tettou771/CadenceSensor/3d/case.3mf

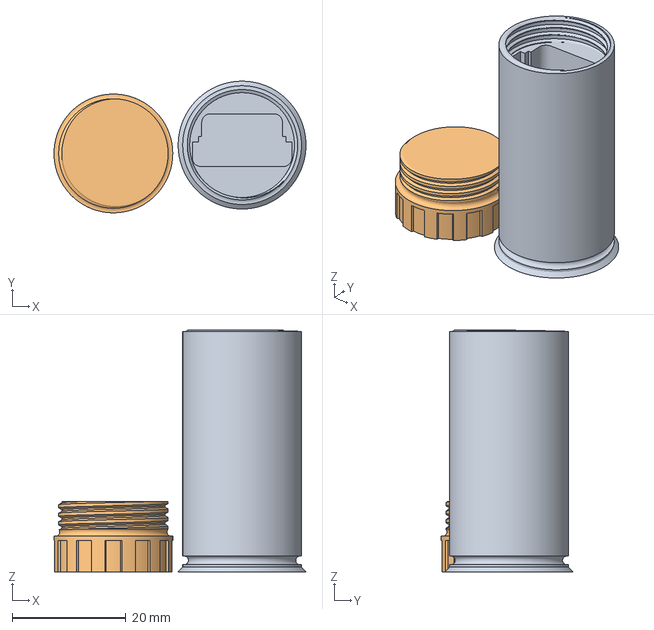
[picture p1: CAD file, 2026-08-18]
3d/case.3mf
44.3 x 23.2 x 42.5 mm
outer.stl
cap.stl
