tettou771/CadenceSensor/KiCad/BikeSensor/BikeSensor.step

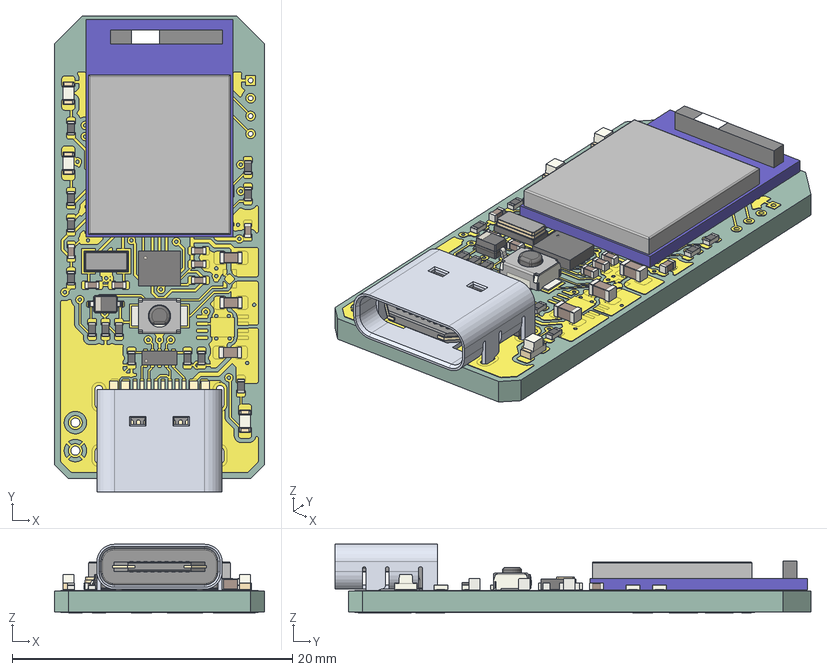
[picture p2: CAD file, 2026-08-17]
KiCad/BikeSensor/BikeSensor.step
15.0 x 34.0 x 4.89 mm
R_0402_1005Metric x 13
LED_0603_1608Metric x 3
C_0402_1005Metric x 7
SW_SPST_B3U-1000P
C_0603_1608Metric x 3
LGA_14_3x25mm_P05mm_LayoutBorder3x4y
D_SOD-323
Crystal_SMD_3215-2Pin_3.2x1.5mm
Raytac_MDBT50Q
USON_10_25x10mm_Pitch05mm
USB Type C Port (SMD Type)
BikeSensor_copper
BikeSensor_PCB
