tettou771/CadenceSensor/KiCad/BikeSensor/BikeSensor.kicad_pcb

## KiCad design KiCad/BikeSensor/BikeSensor.kicad_pcb (2026-08-18)

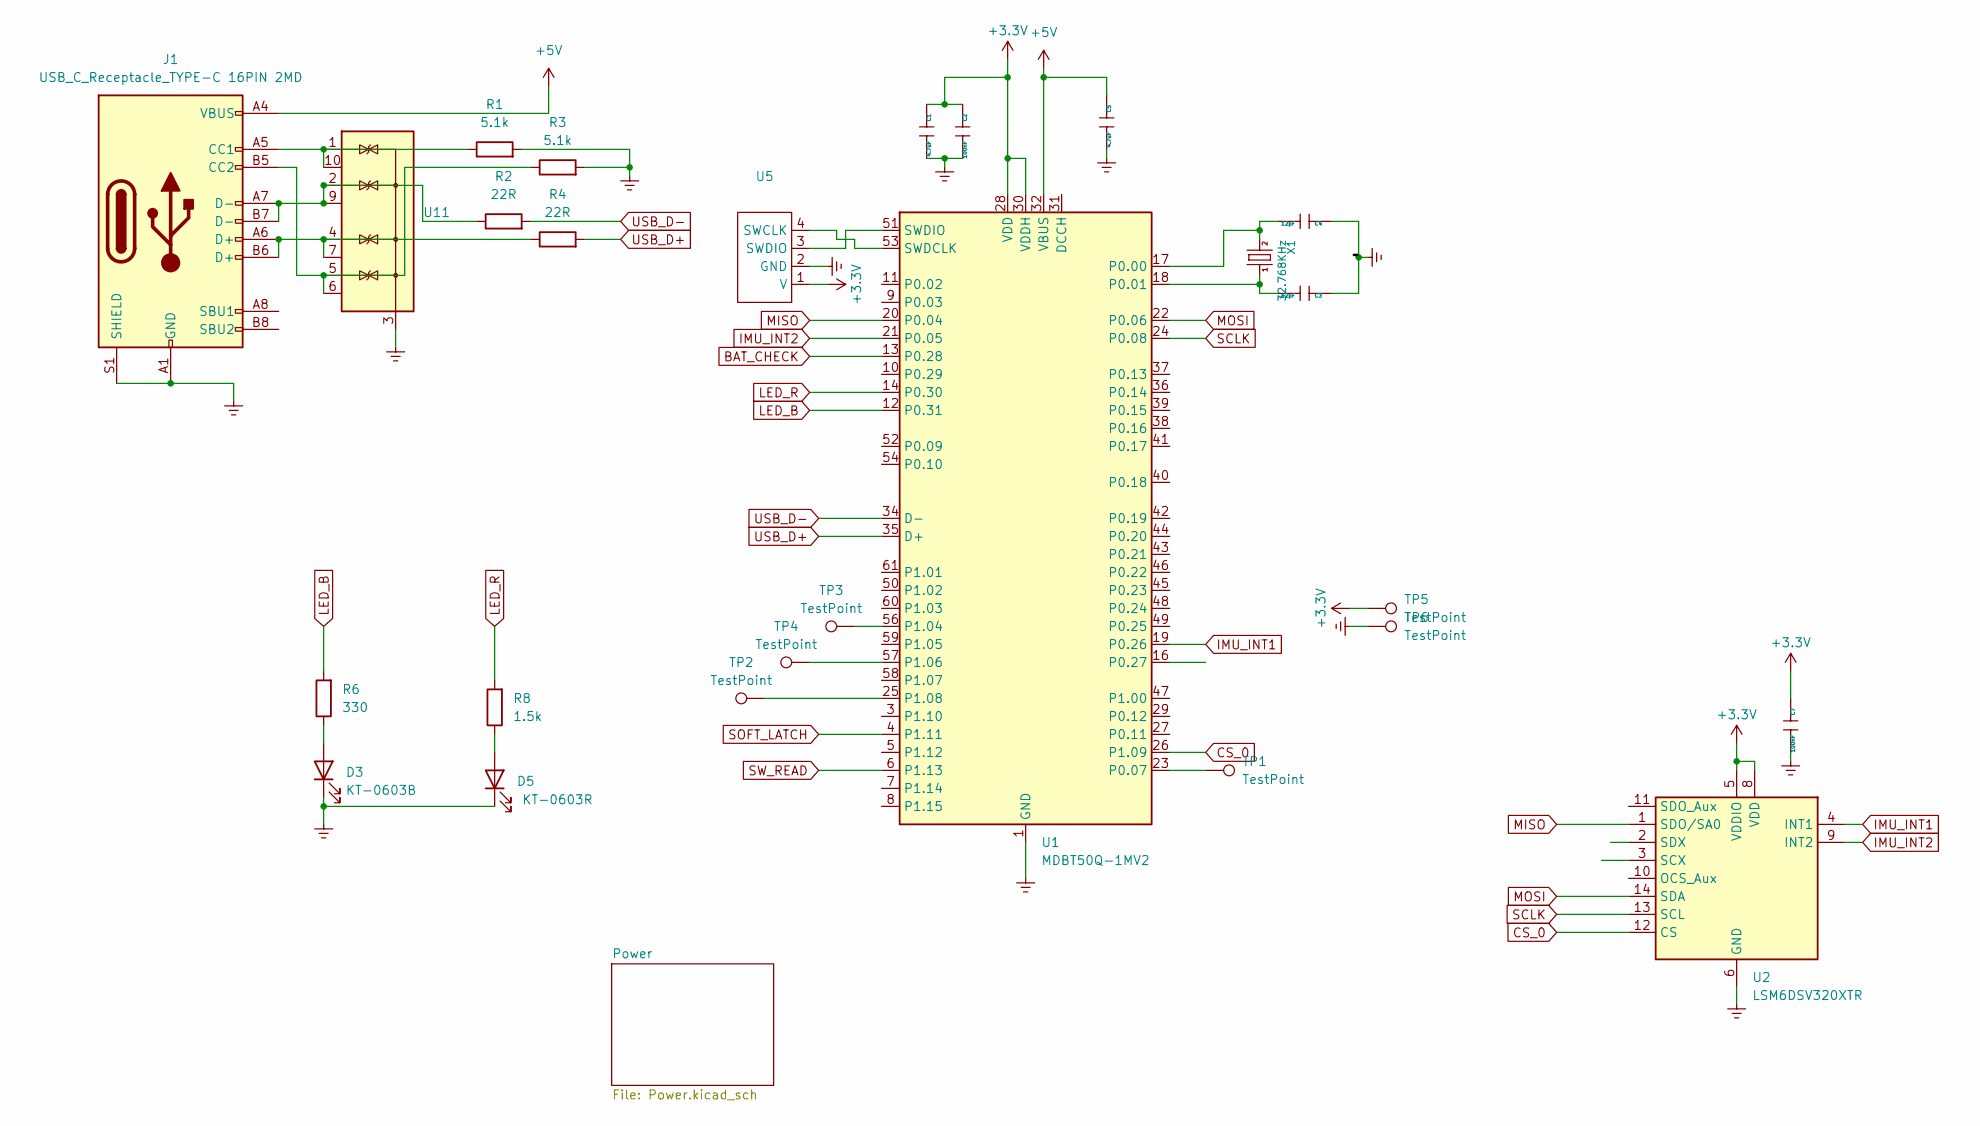
[picture p3: schematic BikeSensor.kicad_sch]

Parts:
C1, C5: 4.7uF; C_0402_1005Metric
C2, C7: 100nF; C_0402_1005Metric
C3, C4: 12pF; C_0402_1005Metric
D3: KT-0603B; LED_0603_1608Metric
D5: KT-0603R; LED_0603_1608Metric
J1: USB_C_Receptacle_TYPE-C 16PIN 2MD
R1, R3: 5.1k; R_0402_1005Metric
R2, R4: 22R; R_0402_1005Metric
R6: 330; R_0402_1005Metric
R8: 1.5k; R_0402_1005Metric
TP1, TP2, TP3, TP4, TP5, TP6: TestPoint; TestPoint_Pad_D1.5mm
U1: MDBT50Q-1MV2; Raytac_MDBT50Q
U2: LSM6DSV320XTR; LGA-14_3x2.5mm_P0.5mm_LayoutBorder3x4y
U5: ICSP_SWD_127
U11: TPD4E02B04DQA; USON-10_2.5x1.0mm_P0.5mm
X1: 32.768KHz; Crystal_SMD_3215-2Pin_3.2x1.5mm

Connections:
+3.3V: C1.1, C2.1, C7.1, TP5.1 (1_1), U1.28 (VDD), U1.30 (VDDH), U2.5 (VDDIO), U2.8 (VDD), U5.1 (V); also elsewhere on the board
+5V: C5.1, J1.A4 (VBUS), J1.A9 (VBUS), J1.B4 (VBUS), J1.B9 (VBUS), U1.32 (VBUS); also elsewhere on the board
BAT_CHECK: U1.13 (P0.28); also elsewhere on the board
CS_0: U1.26 (P1.09), U2.12 (CS)
GND_POWER: C1.2, C2.2, C3.1, C4.1, C5.2, C7.2, D3.1 (K), D5.1 (K), J1.A1 (GND), J1.A12 (GND), J1.B1 (GND), J1.B12 (GND), J1.S1 (SHIELD), R1.2, R3.2, TP6.1 (1_1), U1.1 (GND), U1.2 (GND), U1.15 (GND), U1.33 (GND), U1.55 (GND), U2.6 (GND), U2.7 (GND), U5.2 (GND), U11.3 (G), U11.8 (G); also elsewhere on the board
IMU_INT1: U1.19 (P0.26), U2.4 (INT1)
IMU_INT2: U1.21 (P0.05), U2.9 (INT2)
LED_B: R6.2, U1.12 (P0.31)
LED_R: R8.2, U1.14 (P0.30)
MISO: U1.20 (P0.04), U2.1 (SDO/SA0)
MOSI: U1.22 (P0.06), U2.14 (SDA)
unnamed: D3.2 (A), R6.1
unnamed: D5.2 (A), R8.1
unnamed: J1.A5 (CC1), R1.1, U11.1 (IO1), U11.10 (NC)
unnamed: J1.B5 (CC2), R3.1, U11.5 (IO4), U11.6 (NC)
unnamed: C4.2, U1.17 (P0.00), X1.2
unnamed: C3.2, U1.18 (P0.01), X1.1
unnamed: TP1.1 (1_1), U1.23 (P0.07)
unnamed: TP3.1 (1_1), U1.56 (P1.04)
unnamed: TP4.1 (1_1), U1.57 (P1.06)
unnamed: TP2.1 (1_1), U1.25 (P1.08)
unnamed: U1.53 (SWDCLK), U5.4 (SWCLK)
unnamed: U1.51 (SWDIO), U5.3 (SWDIO)
unnamed: J1.A7 (D-), J1.B7 (D-), R2.1, U11.2 (IO2), U11.9 (NC)
unnamed: J1.A6 (D+), J1.B6 (D+), R4.1, U11.4 (IO3), U11.7 (NC)
SCLK: U1.24 (P0.08), U2.13 (SCL)
SOFT_LATCH: U1.4 (P1.11); also elsewhere on the board
SW_READ: U1.6 (P1.13); also elsewhere on the board
USB_D+: R4.2, U1.35 (D+)
USB_D-: R2.2, U1.34 (D-)

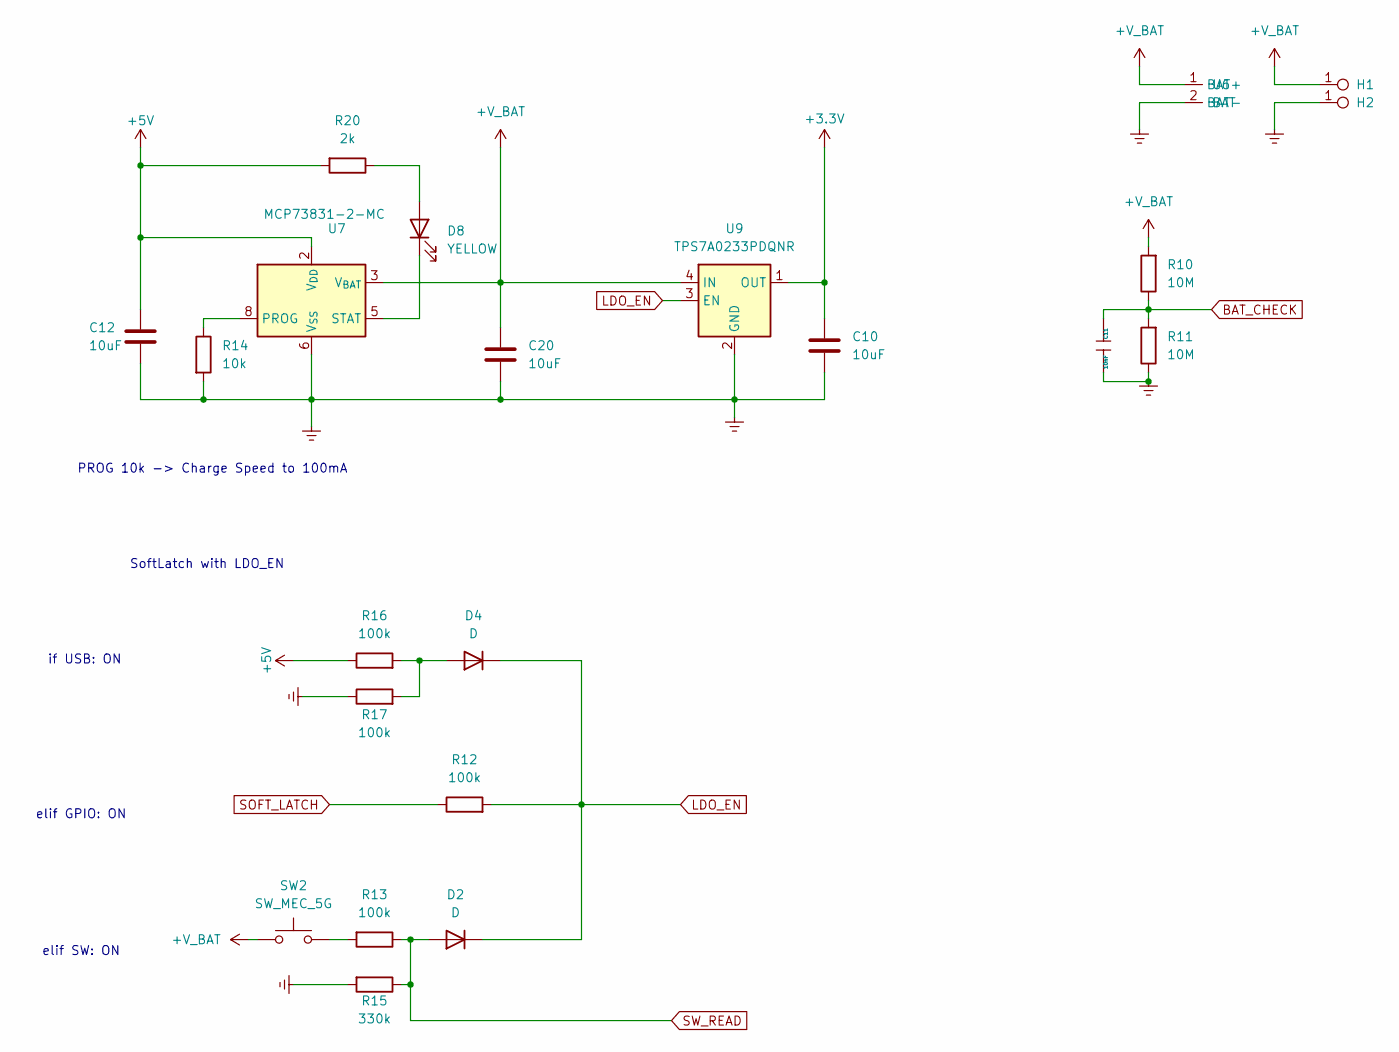
[picture p4: schematic Power.kicad_sch]

Parts:
C10, C12, C20: 10uF; C_0603_1608Metric
C11: 10nF; C_0402_1005Metric
D2, D4: D; D_SOD-323
D8: YELLOW; LED_0603_1608Metric
H1, H2: TH_0.7mm
R10, R11: 10M; R_0402_1005Metric
R12, R13, R16, R17: 100k; R_0402_1005Metric
R14: 10k; R_0402_1005Metric
R15: 330k; R_0402_1005Metric
R20: 2k; R_0402_1005Metric
SW2: SW_MEC_5G; SW_SPST_B3U-1000P
U6: BAT; SPK_PAD
U7: MCP73831-2-MC; DFN-8-1EP_3x2mm_P0.5mm_EP1.7x1.4mm
U9: TPS7A0233PDQNR; Texas_X2SON-4_1x1mm_P0.65mm

Connections:
+3.3V: C10.1, U9.1 (OUT); also elsewhere on the board
+5V: C12.1, R16.1, R20.2, U7.1 (V_{DD}), U7.2 (V_{DD}); also elsewhere on the board
+V_BAT: C20.1, H1.1, R10.2, SW2.1 (A), U6.1 (BAT+), U7.3 (V_{BAT}), U7.4 (V_{BAT}), U9.4 (IN)
BAT_CHECK: C11.1, R10.1, R11.2; also elsewhere on the board
GND_POWER: C10.2, C11.2, C12.2, C20.2, H2.1, R11.1, R14.2, R15.2, R17.1, U6.2 (BAT-), U7.6 (V_{SS}), U9.2 (GND), U9.5 (GND); also elsewhere on the board
LDO_EN: D2.1 (K), D4.1 (K), R12.2, U9.3 (EN)
unnamed: D4.2 (A), R16.2, R17.2
unnamed: D8.2 (A), R20.1
unnamed: D8.1 (K), U7.5 (STAT)
unnamed: R13.2, SW2.2 (B), SW2.3 (B)
unnamed: R14.1, U7.8 (PROG)
SOFT_LATCH: R12.1; also elsewhere on the board
SW_READ: D2.2 (A), R13.1, R15.1; also elsewhere on the board

Notes on the sheet:
elif SW: ON
PROG 10k -> Charge Speed to 100mA
elif GPIO: ON
if USB: ON
SoftLatch with LDO_EN

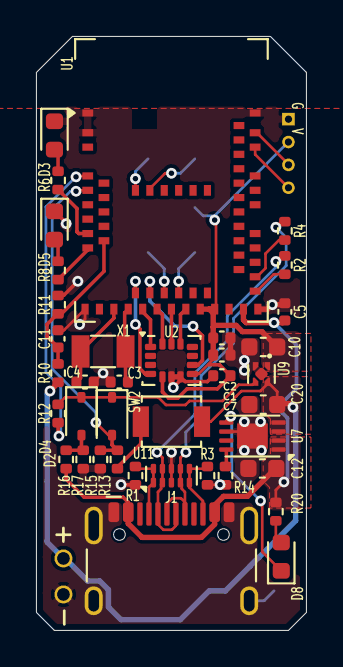
[picture p5: board BikeSensor.kicad_pcb from above]

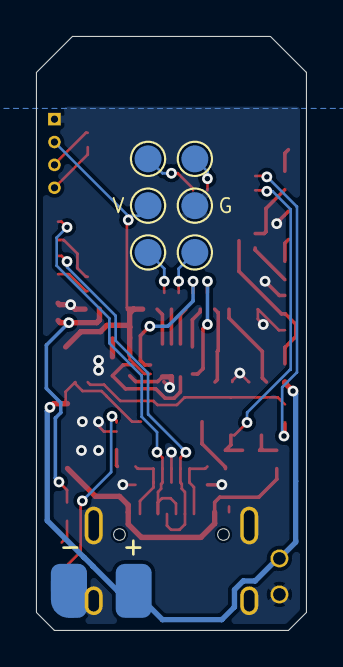
[picture p6: board BikeSensor.kicad_pcb from below]

Board: 2 copper layers, 15.0 x 33.0 mm, 48 parts (7 on the bottom side), 37 nets.
