tettou771/CadenceSensor/(commit log)

2026-08-03 add: bicycle cadence sensor firmware (nRF52840 + LSM6DSV)
    Crank-mounted cadence sensor reporting over the standard BLE Cycling
    Speed and Cadence profile. Derived from the FindMyTag firmware, on the
    RideFormTracker PCB, with the JAVELYTICS USB update flow.
    Cadence is recovered from the rotating gravity vector rather than from a
    gyro, which costs one to two orders of magnitude less current but means
    centripetal acceleration - 2.7 g at 120 rpm, three times the signal -
    has to be subtracted. The DC tracker and low-pass that do so are scaled
    to the measured crank period rather than pinned in Hz; a fixed 8 s
    constant loses 16 of 68 revolutions in a four-second sprint.
    src/cadence.c is exercised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
    [BikeTracker.kicad_pcb, BikeTracker.kicad_sch, Power.kicad_sch]
2026-08-17 add: BikeSensor PCB v1 (renamed from RideFormTracker) and the 320X datasheet
    The KiCad project is renamed to match what it actually became: not a
    RideFormTracker variant but its own 15x33 mm board, with a soft power
    latch, BAT_CHECK moved to an analog-capable pin, and an LSM6DSV320X.
    Also carries the production files as sent to the fab. Those are
    regenerable in principle, but the first article had an open PROG trace -
    the charger sat in its shutdown state and neither charged nor lit its
    status LED - and being able to compare a board in hand against exactly
    what was ordered is worth the few hundred kilobytes.
    [BOM-BikeTracker.csv, BikeSensor.kicad_pcb, BikeSensor.kicad_sch, BikeSensor.step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]
2026-08-17 add: cadence_v1 board, power latch, battery sense and dual BLE links
    The purpose-built PCB differs from the RideFormTracker bring-up board in
    four ways that reach the firmware, so it gets its own board directory
    rather than edits to the old one: two LEDs instead of an RGB and wired
    the other way up, BAT_CHECK on a pin the SAADC can actually see, an
    LSM6DSV320X, and a 3.3 V rail the board switches for itself.
    That last one drives most of this. The LDO's enable pin is held up only
    by the momentary button or by a GPIO through R12, so firmware that never
    asserts the latch runs exactly as long as a finger stays on the button.
    Board init asserts it in BOTH images, because MCUboot spends twenty
    se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
2026-08-18 add: soft-latch rework, 10M battery divider and a 3D-printed case
    Three changes to the enable network, none of which the firmware notices -
    the pin assignments are identical, so one image runs on both revisions.
    R13 moves to sit in series with SW2. The existing SW_READ divider then
    also drops the voltage that reaches LDO_EN, which lands the button path
    at 2.97 V instead of 3.95 V. That matters because R12 ties the enable
    node straight to P1.11: the old level sat just under the GPIO's ESD
    diode and therefore just outside its absolute maximum of VDD + 0.3 V.
    Costs nothing - the divider ratio, the SW_READ level and the 9.8 uA
    drawn while the button is held are all unchanged.
    VBUS reaches the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
    [BOM-BikeSensor.csv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]
2026-08-26 fix: disable USB when the cable goes away
    usb_present latched true on the first cable insertion and nothing ever
    cleared it, and usb_disable() was never called at all. One omission, three
    symptoms that look entirely unrelated from the outside.
    The pack drains. An enabled USB device keeps the peripheral and the high
    frequency crystal alive whether or not a host is there - hundreds of
    microamps against a design whose entire standby figure is eight. A board
    that had been plugged in once measured 8 % within days of a full charge,
    which works out at roughly 0.6 to 1.2 mA average and matches nothing else
    in the budget: even never sleeping at all is only 132 uA.
    The console never comes back. With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
    [main.c]
2026-08-27 add: drop USB when no host is attached
    A cable is not a host. The usual case is a charger, or a PC nobody has
    opened a terminal on, and USB costs about 1.3 mA - which on this board
    comes out of the PACK rather than the cable. The LDO's input is the
    charger's output, so once charging terminates the charger stops sourcing
    and the sensor quietly eats its own battery while apparently plugged in.
    Left on charge overnight it was 9 % down by morning, and the next ride
    would have started at 90 %.
    DTR is what separates the two cases: a charger never raises it, and
    neither does a PC until something opens the port. Five minutes after the
    last host lets go, USB comes down and the draw returns to microa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
2026-09-02 fix: move the IMU off SPIM3, and use a measured discharge curve
    A parked sensor drew 554 uA where it was designed for 8, and flattened a
    150 mAh pack in six days. Almost all of it was one peripheral.
    nRF52840 anomaly 195 leaves SPIM3 drawing several hundred microamps after
    use. nrfx carries the workaround - a write to 0x4002F004 - but it lives
    inside nrfx_spim_uninit(), which Zephyr reaches only when suspending the
    device, which needs the system power management this application does not
    run. So a fix that shipped in the SDK never executed once.
    Moving the bus to SPIM1 costs nothing. SPIM3's advantage is 32 Mbps; this
    runs at 8, and the LSM6DSV320X itself tops out at 10 (fc(SPC) in its dat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
    [battery.c, main.c]
2026-09-02 add: sleep in System OFF after ten quiet minutes
    Parked, the sensor drew 30 uA doing nothing anybody asked for. The
    accelerometer accounts for 4.5 of that and the battery divider 1.85; the
    rest is the cost of leaving a core, its clocks and a Bluetooth stack
    running so they can wait. System OFF stops paying it. Measured on the
    bench across a 100 ohm shunt: 30 uA -> 8 uA, which roughly doubles the
    life of a charge.
    Waking is what makes this work at all, and it needed two things that are
    easy to get wrong in opposite directions.
    The interrupt must be re-armed as a LEVEL before going down. An edge
    interrupt runs through GPIOTE, and GPIOTE is one of the peripherals
    System OFF powers off; the on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
    [main.c]
2026-09-24 fix: let the quiet timer, not a collector, decide when to sleep
    A central is under no obligation to release a link, and an Apple Watch
    left in radio range does not. Holding the link kept the sensor out of
    System OFF indefinitely and pinned the sampler at 60 Hz, which is the
    likeliest explanation for a pack that went flat in eight days.
    Hang up once the crank has been still for SYSTEM_OFF_MS, and bound the
    sampler hold to the same two-minute window advertising uses. Add
    __noinit lifetime counters so time spent awake survives System OFF and
    can be read back without an ammeter.
    [ble_csc.c, ble_csc.h, main.c]
2026-09-24 fix: keep the lifetime counters in retained RAM, not just __noinit
    __noinit only keeps the startup code from zeroing a variable; it says
    nothing about whether that RAM is still powered. System OFF drops RAM
    section by section, so the counters came back empty on every wake and
    the board reported "1 wakes" forever.
    Setting the retention bits by hand did not help either: sys_poweroff()
    disables retention for all of RAM on its way out, two statements before
    it stops the core. Only regions declared as zephyr,retained-ram in the
    devicetree are switched back on, so declare one and place the counters
    there. Verified on hardware: 2 wakes, awake 601 s against an uptime of 7.
    [main.c]
2026-10-06 add: count USB, VBUS and advertising time across System OFF
    A pack that drains while nobody watches needs the sensor to say how it
    spent the time. Add seconds with the USB stack up, seconds VBUS read as
    present, seconds advertising, and the last pack voltage read with no
    cable in, all in the retained region so they survive System OFF.
    On hardware these showed the board in System OFF for ~8 hours with no
    VBUS and no advertising while the pack still lost about 38 mAh, which
    puts the drain outside the firmware.
